itsmeibii/VTOL/BOM_digikey.csv

Reference | Qty | Value | Description | Manufacturer | Manufacturer Part Number | DigiKey Link | Footprint | Checked on DigiKey | Notes
U4 | 1 | ESP32-S3-WROOM-1-N8 | Wi-Fi/BLE module, 8MB flash, no PSRAM, PCB antenna | Espressif Systems | ESP32-S3-WROOM-1-N8 | https://www.digikey.com/en/products/result?keywords=ESP32-S3-WROOM-1-N8 | VTOL_parts:ESP32-S3-WROOM-1_Via0.3mm | Yes (user-checked 2026-09-25) | N8R2 not available on DigiKey; PSRAM not needed. PCB-antenna variant; do NOT substitute -1U (U.FL, different size)
U6 | 1 | 3.3V 1A LDO | LDO 3.3V 1A, 360mV dropout, SOT-223R (pin1 GND, pin2/tab OUT, pin3 IN) | Diodes Incorporated | AP7361C-33ER-13 | https://www.digikey.com/en/products/detail/diodes-incorporated/AP7361C-33ER-13/5768480 | Package_TO_SOT_SMD:SOT-223-3_TabPin2 | Yes | Replaces AMS1117-3.3 (DigiKey only carries clones). Same pinout as AMS1117 in the 'ER' package - do NOT order AP7361C-33E-13 (pin1=IN). VIN max 6.0V
U7 | 1 | R-78E5.0-1.0 | DC/DC buck module SIP3, 8-28V in, 5V 1A out, ~90% eff., short-circuit protected | RECOM Power | R-78E5.0-1.0 | https://www.digikey.com/en/products/detail/recom-power/R-78E5-0-1-0/4930585 | Converter_DCDC:Converter_DCDC_RECOM_R-78E-0.5_THT | Yes | 4S LiPo (12.8-16.8V) -> 5V (net BATT_5V) -> SW3. Pinout 1=IN 2=GND 3=OUT. 1A max; the board is fused at 1.1A anyway
U5 | 1 | USBLC6-2SC6 | USB ESD protection, SOT-23-6 | UMW | USBLC6-2SC6 | https://www.digikey.com/en/products/detail/umw/usblc6-2sc6/16705896 | Package_TO_SOT_SMD:SOT-23-6 | Yes (user-checked 2026-09-25) | ST USBLC6-2SC6 out of stock; UMW clone, same SOT-23-6 pinout
U2 | 1 | SEN66 | Air quality module: PM1/2.5/4/10, RH, T, VOC, NOx, CO2; I2C 0x6B, 3.3V | Sensirion | SEN66-SIN-T | https://www.digikey.com/en/products/detail/sensirion-ag/SEN66-SIN-T/25700945 | - (off-board, cable to J8) | Yes (user-chosen 2026-09-25) | Replaces SEN0460 + Si7021/HDC1080. 3.15-3.6V supply (runs on +3.3V), 90-110mA avg, 300-350mA peaks; cable <=50cm
D1 | 1 | SMF5.0A | TVS diode unidirectional, 5V standoff, 9.2V clamp, 200W, SOD-123FL (on 5V_FUSED) | Littelfuse | SMF5.0A | https://www.digikey.com/en/products/detail/littelfuse-inc/SMF5-0A/3429605 | Diode_SMD:D_SOD-123F | Yes (search result, 2026-09-25) | Nexperia PTVS5V0Z1USKYL out of stock. Same-spec alternates: SMC Diode Solutions SMF5.0A, MCC SMF5.0A-TP. Cathode band = pad 1 = 5V_FUSED
F1 | 1 | 1.1A PTC | Resettable PTC fuse, 1.1A hold / 2.2A trip, 6V, 1206 | Bourns | MF-NSMF110-2 | https://www.digikey.com/en/products/detail/bourns-inc/MF-NSMF110-2/662810 | Fuse:Fuse_1206_3216Metric_Pad1.42x1.75mm_HandSolder | Yes ($0.36) | 6V max: fine | it sits after the 5V switch (never sees battery voltage)
C7 | 1 | 10uF 50V | MLCC 10uF 50V X5R 1206 (input cap for U7, on raw 4S battery) | TDK | C3216X5R1H106K160AB | https://www.digikey.com/en/products/result?keywords=C3216X5R1H106K160AB | Capacitor_SMD:C_1206_3216Metric_Pad1.33x1.80mm_HandSolder | Yes (user-checked 2026-09-25) | Samsung CL31A106KBHNNNE out of stock. 50V rating needed: 4S pack reaches 16.8V. C13 electrolytic does the hot-plug damping
C13 | 1 | 47uF 35V | Aluminum electrolytic 47uF 35V SMD 6.3x5.8mm (hot-plug damping on +BATT) | Panasonic | EEE-FK1V470P | https://www.digikey.com/en/products/detail/panasonic-electronic-components/EEE-FK1V470P/766010 | Capacitor_SMD:CP_Elec_6.3x5.8 | Yes (search result) | Damps LC ringing when the 4S pack is plugged in, which can overshoot past the R-78E's 28V max input. Polarized: + toward U7
C1,C5,C11,C12 | 4 | 10uF 25V | MLCC 10uF 25V X7R 0805 | Cal-Chip Electronics | GMC21X7R106K25NT | https://www.digikey.com/en/products/result?keywords=4713-GMC21X7R106K25NTCT-ND | Capacitor_SMD:C_0805_2012Metric_Pad1.18x1.45mm_HandSolder | Yes (user-checked 2026-09-25, DigiKey 4713-GMC21X7R106K25NTCT-ND) | Samsung CL21A106KAYNNNE out of stock. C1 = LDO input / 5V bulk (<=10uF keeps USB VBUS inrush in spec), C5 = LDO output (AP7361C wants >=2.2uF ceramic), C11 = ESP32 3V3, C12 = U7 output
C14 | 1 | 47uF 10V | MLCC 47uF 10V X5R 1206 (bulk cap at SEN66 connector J8) | Murata | GRM31CR61A476KE15L | https://www.digikey.com/en/products/result?keywords=GRM31CR61A476KE15L | Capacitor_SMD:C_1206_3216Metric_Pad1.33x1.80mm_HandSolder | Yes (user-checked 2026-09-25) | Samsung CL31A476MPHNNNE out of stock. Supplies SEN66 300-350mA CO2-sensor pulses
C4,C10 | 2 | 0.1uF 50V | MLCC 0.1uF 50V X7R 0603 | KEMET | C0603C104K5RACTU | https://www.digikey.com/en/products/result?keywords=399-C0603C104K5RACTUCT-ND | Capacitor_SMD:C_0603_1608Metric_Pad1.08x0.95mm_HandSolder | Yes (user-checked 2026-09-25, DigiKey 399-C0603C104K5RACTUCT-ND) | Samsung CL10B104KB8NNNC out of stock
C3 | 1 | 1uF 50V | MLCC 1uF 50V X5R 0603 (ESP32 EN reset delay, with R1 10k) | Samsung Electro-Mechanics | CL10A105KB8NNNC | https://www.digikey.com/en/products/result?keywords=1276-1860-1-ND | Capacitor_SMD:C_0603_1608Metric_Pad1.08x0.95mm_HandSolder | Yes (user-checked 2026-09-25, DigiKey 1276-1860-1-ND) | CL10B105KB8NNNC (X7R) out of stock; X5R fine for the EN RC
R1,R2 | 2 | 10k | Resistor 10k 1% 0.1W 0603 | YAGEO | RC0603FR-0710KL | https://www.digikey.com/en/products/result?keywords=RC0603FR-0710KL | Resistor_SMD:R_0603_1608Metric_Pad0.98x0.95mm_HandSolder | Not individually | Common stock part
R3,R4 | 2 | 4.7k | Resistor 4.7k 1% 0.1W 0603 | YAGEO | RC0603FR-074K7L | https://www.digikey.com/en/products/result?keywords=RC0603FR-074K7L | Resistor_SMD:R_0603_1608Metric_Pad0.98x0.95mm_HandSolder | Not individually | SDA/SCL pull-ups (ESP32 I2C bus: SEN66 + J9/J10)
R5,R9 | 2 | 5.1k | Resistor 5.1k 1% 0.1W 0603 (USB-C CC pull-downs) | YAGEO | RC0603FR-075K1L | https://www.digikey.com/en/products/result?keywords=RC0603FR-075K1L | Resistor_SMD:R_0603_1608Metric_Pad0.98x0.95mm_HandSolder | Not individually | Common stock part
SW1,SW2 | 2 | RESET / BOOT | Tactile switch SPST-NO 6x6mm SMD, 4.3mm height | C&K | PTS645SM43SMTR92 LFS | https://www.digikey.com/en/products/detail/c-k/PTS645SM43SMTR92-LFS/1146840 | Button_Switch_SMD:SW_SPST_PTS645Sx43SMTR92 | Yes
SW3 | 1 | SPDT power select | Slide switch SPDT on-on, 6A/28VDC, through-hole right angle | C&K | 1101M2S3AQE2 | https://www.digikey.com/en/products/detail/c-k/1101M2S3AQE2/67052 | VTOL_parts:SW_Slide_SPDT_RightAngle_CK_1101M2S3AQE2 | Yes | Rated 6A/28VDC (the Nidec CAS-120A1 was only 0.1A). Footprint hand-drawn from the C&K datasheet (right-angle 'A' termination) - check it against a real part
J5 | 1 | USB-C 2.0 receptacle | USB-C 16P USB 2.0 receptacle, SMD + THT shell, top mount | GCT | USB4105-GF-A | https://www.digikey.com/en/products/detail/gct/USB4105-GF-A/11198441 | VTOL_parts:USB_C_Receptacle_GCT_USB4105-GF-A_16P_TopMnt_Horizontal_S1 | Yes | DigiKey does not stock HRO TYPE-C-31-M-12. Uses a copy of the KiCad GCT USB4105 footprint with the shield pads renamed S1 to match the symbol
J8 | 1 | JST GH 6-pin | JST GH 1.25mm 6-pos SMD right-angle header (SEN66 cable) | JST | SM06B-GHS-TB(LF)(SN) | https://www.digikey.com/en/products/detail/jst-sales-america-inc/SM06B-GHS-TB/807790 | Connector_JST:JST_GH_SM06B-GHS-TB_1x06-1MP_P1.25mm_Horizontal | Yes (~11k stock) | Pinout = SEN66: 1 VDD, 2 GND, 3 SDA, 4 SCL, 5 GND, 6 VDD
CABLE2 | 1 | JST GH 6-pin cable | JST GH 6-pin socket-to-socket cable, 100mm (SEN66 to J8) | Adafruit | 5754 | https://www.adafruit.com/product/5754 | - | Not on DigiKey page checked | Must be straight-through (J8 pin N -> SEN66 pin N). Sensirion only lists GH-to-jumper-wire sets; alternative: crimp GHR-06V-S housings
J7,J9,J10 | 1 | 40-pin 2.54mm header strip | Male header 1x40 2.54mm breakaway, through-hole vertical | Sullins Connector Solutions | PRPC040SAAN-RC | https://www.digikey.com/en/products/result?keywords=PRPC040SAAN-RC | Connector_PinHeader_2.54mm:PinHeader_1x0N_P2.54mm_Vertical | Not individually | Break into 1x3 (J7 Pi UART: ESP_RX, ESP_TX, GND) + 1x4 (J9) + 1x4 (J10); J9/J10 = I2C expansion headers (GND, 3V3, SDA, SCL)
J6 | 1 | Battery connector | JST PH 2.0mm 2-pos right-angle through-hole header, 2A | JST | S2B-PH-K-S(LF)(SN) | https://www.digikey.com/en/products/result?keywords=S2B-PH-K-S | Connector_JST:JST_PH_S2B-PH-K_1x02_P2.00mm_Horizontal | Not individually | Standard keyed battery connector (4S LiPo input; check pin 1 = + on the battery lead)
H1,H2,H3,H5 | 0 | MountingHole | M3 plated mounting hole | - | - | - | MountingHole:MountingHole_3.2mm_M3_Pad_Via | - | No part (PCB feature)
