itsmeibii/VTOL/VTOL.kicad_sch

## KiCad design VTOL.kicad_sch (2026-10-11, an earlier design)

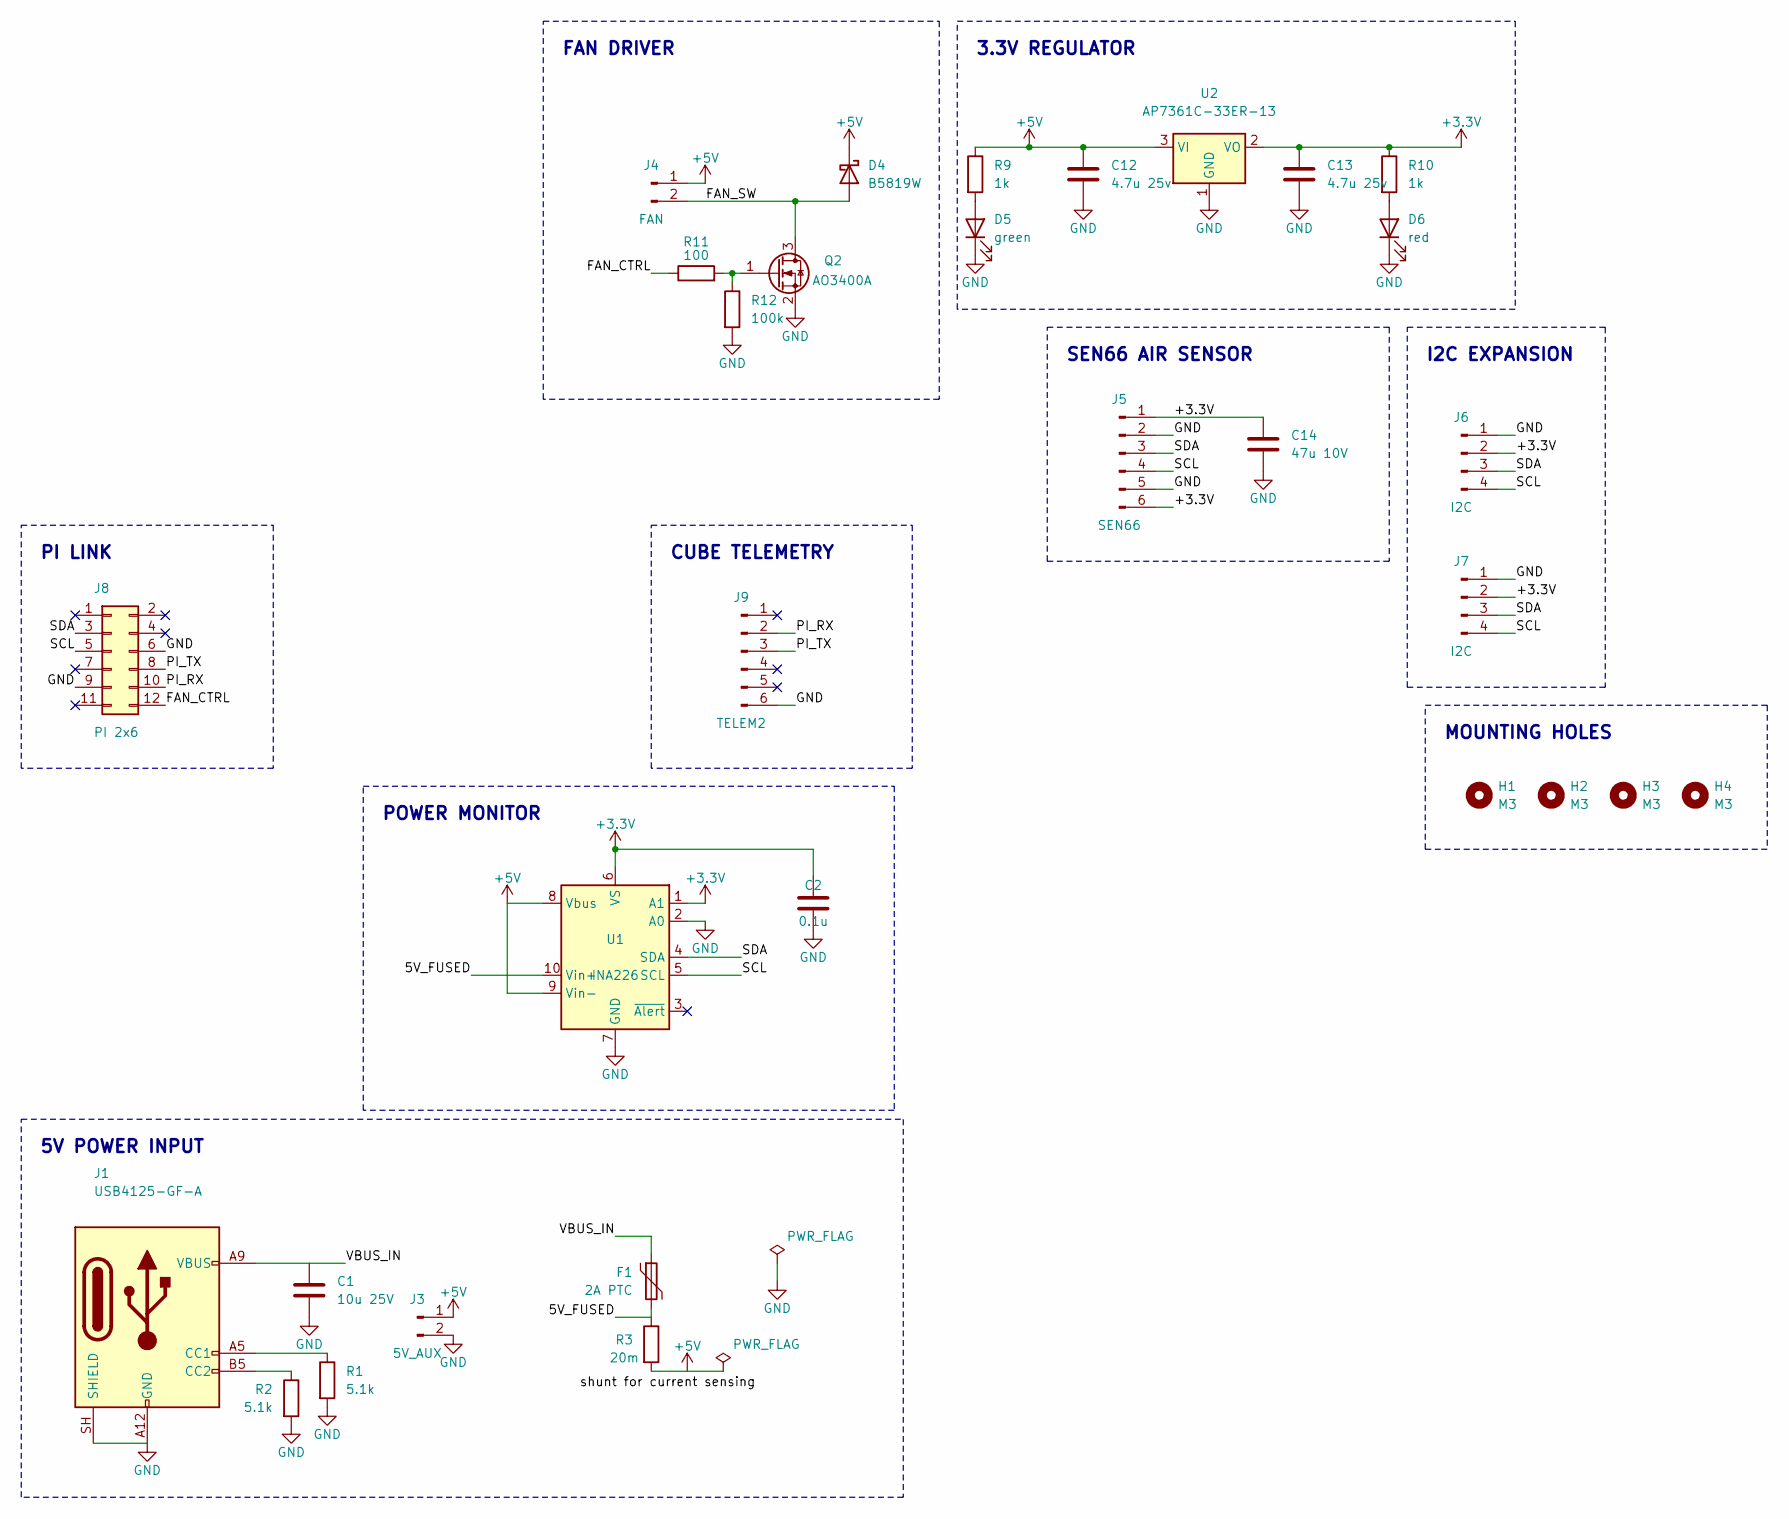
[picture p1: schematic VTOL.kicad_sch]

Parts:
C1: 10u 25V; C_0805_2012Metric_Pad1.18x1.45mm_HandSolder; MPN Cal-Chip GMC21X7R106K25NT; Digikey Part # 4713-GMC21X7R106K25NTCT-ND
C2: 0.1u; C_0603_1608Metric_Pad1.08x0.95mm_HandSolder; MPN KEMET C0603C104K3RACTU; Digikey Part # 399-C0603C104K3RACTUCT-ND
C12, C13: 4.7u 25v; C_0805_2012Metric_Pad1.18x1.45mm_HandSolder; MPN Taiyo Yuden TMK212AB7475KG-T; Digikey Part # 587-2990-1-ND
C14: 47u 10V; C_1206_3216Metric_Pad1.33x1.80mm_HandSolder; MPN KEMET C1206C476M8PACTU; Digikey Part # 399-C1206C476M8PACTUCT-ND
D4: B5819W; D_SOD-123; MPN Diodes Inc B5819W; Digikey Part # 5399-B5819WCT-ND
D5: green; LED_0603_1608Metric_Pad1.05x0.95mm_HandSolder; MPN Wurth 150060GS75000; Digikey Part # 732-4971-1-ND
D6: red; LED_0603_1608Metric_Pad1.05x0.95mm_HandSolder; MPN Wurth 150060RS75000; Digikey Part # 732-4978-1-ND
F1: 2A PTC; Fuse_1812_4532Metric; MPN Bourns MF-MSMF200-2; Digikey Part # MF-MSMF200-2CT-ND
H1, H2, H3, H4: M3; MountingHole_3.2mm_M3
J1: USB4125-GF-A; USB_C_Receptacle_GCT_USB4125-xx-x_6P_TopMnt_Horizontal; MPN GCT USB4125-GF-A; Digikey Part # 2073-USB4125-GF-ACT-ND
J3: 5V_AUX; PinHeader_1x02_P2.54mm_Vertical; MPN Sullins PRPC002SAAN-RC; Digikey Part # 35-PRPC002SAAN-RC-ND
J4: FAN; PinHeader_1x02_P2.54mm_Vertical; MPN Sullins PRPC002SAAN-RC; Digikey Part # 35-PRPC002SAAN-RC-ND
J5: SEN66; JST_GH_BM06B-GHS-TBT_1x06-1MP_P1.25mm_Vertical; MPN JST BM06B-GHS-TBT; Digikey Part # 455-BM06B-GHS-TBTCT-ND
J6, J7: I2C; PinHeader_1x04_P2.54mm_Vertical; MPN Sullins PRPC004SAAN-RC; Digikey Part # 35-PRPC004SAAN-RC-ND
J8: PI 2x6; IDC-Header_2x06_P2.54mm_Vertical_Drill1.1; MPN Molex 0702461201; Digikey Part # 23-0702461201-ND
J9: TELEM2; JST_GH_BM06B-GHS-TBT_1x06-1MP_P1.25mm_Vertical; MPN JST BM06B-GHS-TBT; Digikey Part # 455-BM06B-GHS-TBTCT-ND
Q2: AO3400A; SOT-23; MPN Alpha & Omega AO3400A; Digikey Part # 785-1000-1-ND
R1, R2: 5.1k; R_0603_1608Metric_Pad0.98x0.95mm_HandSolder; MPN Panasonic ERJ-3EKF5101V; Digikey Part # P5.10KHCT-ND
R3: 20m; R_1206_3216Metric_Pad1.30x1.75mm_HandSolder; MPN Stackpole CSR1206FK20L0; Digikey Part # CSR1206FK20L0CT-ND
R9, R10: 1k; R_0603_1608Metric_Pad0.98x0.95mm_HandSolder; MPN Panasonic ERJ-3EKF1001V; Digikey Part # P1.00KHCT-ND
R11: 100; R_0603_1608Metric_Pad0.98x0.95mm_HandSolder; MPN Panasonic ERJ-3EKF1000V; Digikey Part # P100HCT-ND
R12: 100k; R_0603_1608Metric_Pad0.98x0.95mm_HandSolder; MPN Bourns CR0603-FX-1003ELF; Digikey Part # CR0603-FX-1003ELFCT-ND
U1: INA226; MSOP-10_3x3mm_P0.5mm; Digikey Part # 296-29034-1-ND
U2: AP7361C-33ER-13; SOT-223-3_TabPin2; MPN Diodes Inc AP7361C-33ER-13; Digikey Part # AP7361C-33ER-13DICT-ND

Connections:
5V_FUSED: F1.2, R3.1, U1.10 (Vin+)
+3.3V: C2.1, C13.1, C14.1, J5.1, J5.6, J6.2, J7.2, R10.1, U1.1 (A1), U1.6 (VS), U2.2 (VO)
+5V: C12.1, D4.1 (K), J3.1, J4.1, R3.2, R9.1, U1.8 (Vbus), U1.9 (Vin-), U2.3 (VI)
FAN_CTRL: J8.12, R11.1
FAN_SW: D4.2 (A), J4.2, Q2.3 (D)
GND: C1.2, C2.2, C12.2, C13.2, C14.2, D5.1 (K), D6.1 (K), J1.A12 (GND), J1.B12 (GND), J1.SH (SHIELD), J3.2, J5.2, J5.5, J6.1, J7.1, J8.6, J8.9, J9.6, Q2.2 (S), R1.2, R2.2, R12.2, U1.2 (A0), U1.7 (GND), U2.1 (GND)
unnamed: D5.2 (A), R9.2
unnamed: D6.2 (A), R10.2
unnamed: J1.A5 (CC1), R1.1
unnamed: J1.B5 (CC2), R2.1
unnamed: Q2.1 (G), R11.2, R12.1
PI_RX: J8.10, J9.2
PI_TX: J8.8, J9.3
SCL: J5.4, J6.4, J7.4, J8.5, U1.5 (SCL)
SDA: J5.3, J6.3, J7.3, J8.3, U1.4 (SDA)
VBUS_IN: C1.1, F1.1, J1.A9 (VBUS), J1.B9 (VBUS)

Notes on the sheet:
3.3V REGULATOR
MOUNTING HOLES
PI LINK
CUBE TELEMETRY
SEN66 AIR SENSOR
5V POWER INPUT
I2C EXPANSION
FAN DRIVER
POWER MONITOR
