itsmeibii/VTOL/(commit log)

2026-04-10 power and i2c pins
    [VTOL.kicad_pcb, VTOL.kicad_sch]
2026-04-23 finished the schem
    [VTOL.kicad_pcb, VTOL.kicad_sch, sensors.kicad_sch]
2026-04-23 barely finished pcb
    [VTOL.kicad_pcb, VTOL.kicad_sch]
2026-09-25 Snapshot before PCB cleanup/re-route
    Schematic fixes (C1/C5 polarity, SEN0460 on 5V_FUSED, decoupling C8-C11, labels) and current messy PCB, saved so the re-layout can be reverted.
2026-09-30 Rework power, sensors and PCB layout; add DigiKey BOM
    - Power: 4S LiPo input (J6 -> F2 polyfuse -> R-78E 5V buck) with hot-plug
    damping cap (C13), USB/battery select switch SW3, AP7361C LDO with
    ceramic caps.
    - Sensors: SEN66 (J8) replaces SEN0460/Si7021/DS18B20; two I2C headers.
    - Pi link reduced to a 3-pin UART; camera pass-through removed.
    - PCB: re-placed by function, 4-layer (GND + 3V3 planes), rerouted,
    DigiKey footprint swaps in the VTOL_parts library, sub-board removed.
    - Schematic tidy: decoupling caps grouped on shared rails; drop redundant
    C2/C6 0.1u caps.
    - BOM_digikey.csv for DigiKey BOM Manager.
2026-10-11 Add INA226 power monitor, finish part selection, clear PCB
    - Schematic: INA226 (U1) + 20m shunt (R3) + C2 on the 5V rail, I2C 0x44
    - Sections boxed and titled; on-sheet notes removed
    - Footprint and DigiKey part # set for every part
    - J8 -> Molex 0702461201 with 1.1mm-drill IDC 2x06 footprint
    - D6 -> red LED on 3.3V
    - PCB cleared for re-layout
2026-10-11 Schematic save from KiCad
